tdjastrzebski/All-Purpose-Micro-Controller-2/Hardware/Order 2026-08.txt

667-EVQ-P0E07K	2
640-1006A0127C4084T	2
640-USB4105-GF-A-120	5
621-AP7361EA-33E-13	2
710-9774040243R	4
612-TL1014BF160QG	2
179-TS276824G260D	2
187-CL10C101JB8NNNC	4
581-KAM21BG82A101JT	8
179-TS27-CAP	2
637-BAT46WS	4
576-SZSMF6L5.0AT3G	2
241-SS2030FLAUR100A1	2
179-RIC122S11K5SUSMT	2
855-R25-1000602	8
710-9774030243R	8
649-20211120014T1LF	2
737-EBWA-05-A	6
737-2PH1R-03-UA	6
517-929870-01-08-30	2
713-110990037	2
81-1248AS-H-330MP3	2
6521-SRR5828A-3R3Y	2
512-FDT86102LZ	2
621-DMP6023LE-13	8
754-RR0816Q-110D	2
603-RT0603BRD07887KL	2
754-RR0816P-364D	2
754-RR0816P-271D	4
603-RT0603BRD071K69L	4
754-RR0816P-432D	6
603-RT0603DRE075K6L	2
754-RR0816P-681D	2
603-RT0603DRE073K3L	4
603-RT0603FRE07510RL	4
754-RR0816P-273D	2
667-EXB-2HV103JV	2
667-ERA-3AEB1623V	4
667-ERA-3AEB1153V	4
754-RR0816P-1912D28C	2
81-BLM18AG331SN1D	2
576-LCFE201202A900TG	2
595-TXU0202DCUR	4
511-M95P32-IXMNT/E	2
511-STM32U575CIT6	2
595-XTR200DQCR	4
595-TPS7A2031PDBVR	2
595-PCA9306TDCURQ1	2
595-LM74703QDDFRQ1	2
595-TPS62162DSGR	2
595-OPA2387DSGR	2
595-TPS259461ARPWR	2
595-TUSB320LAIRWBR	2
595-LMR38015SDRRR	2
511-STMPS2171STR	10
595-OPA387DBVR	2
575-8212200210002101	4
595-REF3425TIDBVR	2
511-STM32G071GBU6	2
595-ADS114S08BIRHBT	2
667-ERA-3AEB112V	10
603-RT0603BRD0768KL	10
81-GCM21BR71A225KA7K	10
754-RR0816P-271D	10
81-GCM21BR71A225KA7K	10
640-TBD05-02-1-G-G	2
640-TBD05-05-1-G-G	4
511-STM32U575CIT6	2
511-ST67W611M1A6UTR	2
538-146175-0001	2
575-8212200210002101	4
640-SIM8055611400A	2
595-TPD3F303DPVR	2
511-STM32U575CIT6	2
81-GRM0335C1E390FA1D	10
81-LQW15AN68NG00D	2
81-BLM18SD220SN1D	2
594-MCS04020C1004FE0	10
754-RG1005P-104DT10	10
200-RSP-122811-01	4
81-GRM022R60G104ME5L	20
