tdjastrzebski/All-Purpose-Micro-Controller-2/Hardware/APMC.kicad_pcb

## KiCad design Hardware/APMC.kicad_pcb (2026-09-16)

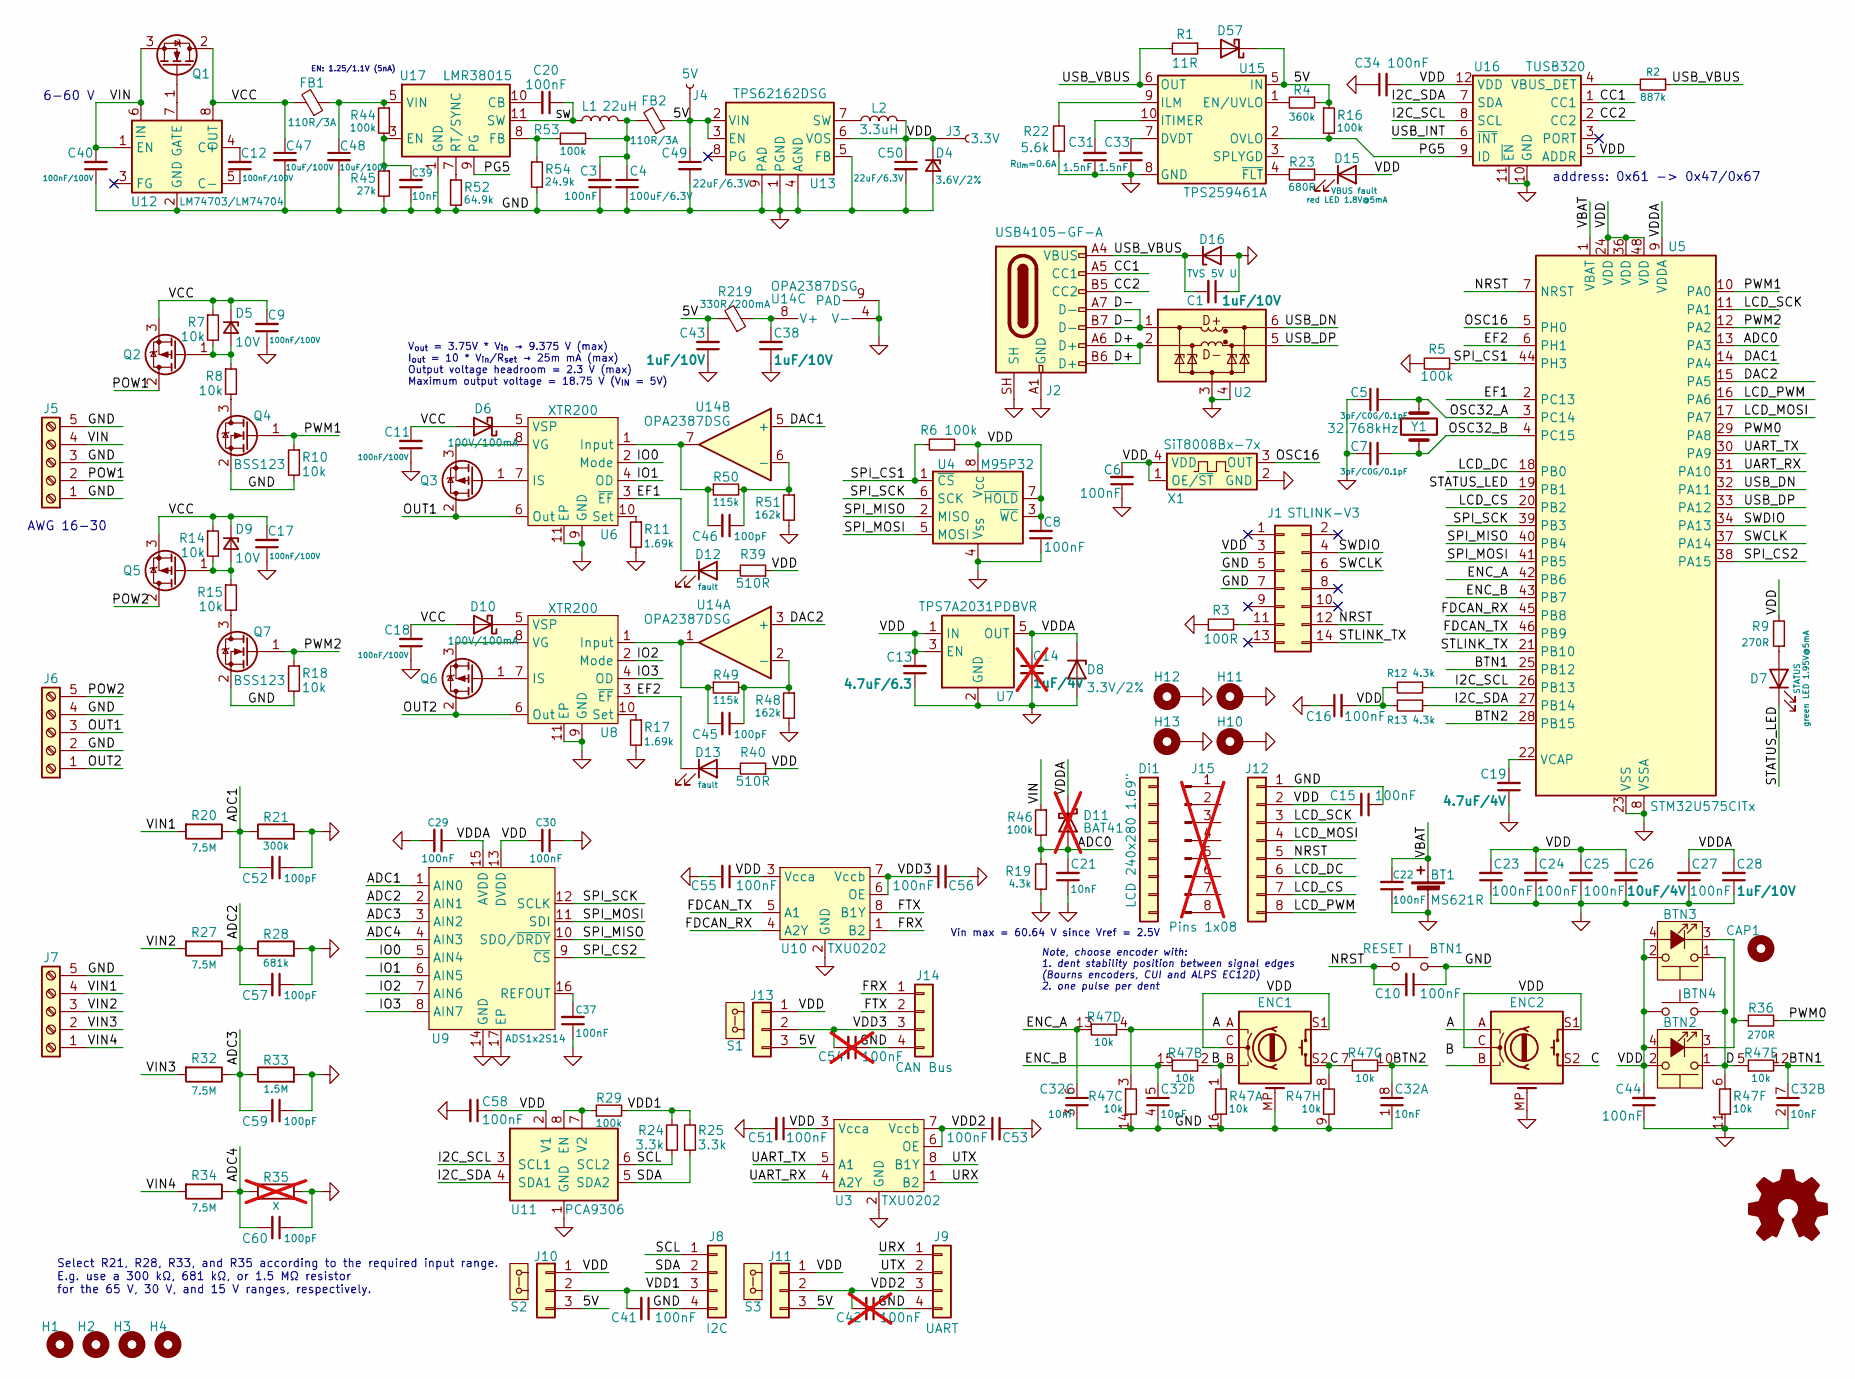
[picture p20: schematic APMC.kicad_sch, All-purpose Micro Controller (APMC)]

Parts:
BT1: MS621R; Seiko_MS621R-II27E; Mouser 628-MS621R-II27E
BTN1: tactile switch 4.7x3.5; SideTactileSwitch_4.7x3.5; Mouser 612-TL1014BF160QG
BTN2: tactile switch 6x6; tactile_switch_12x12_LED; Mouser 179-TS2912121G300D
BTN3: tactile switch 6x6; tactile_switch_6x6_LED; Mouser 179-TS276824G260D
BTN4: SW_Push; Schurter_MCS-18a; Mouser 693-1241.1104.7097
C1, C28, C38, C43: 1uF/10V; C_0603_1608Metric_Pad0.98x0.95mm_HandSolder; Mouser 810-CGA3E2X5R1A105MA
C3, C10, C15, C20, C23, C24, C27, C44: 100nF; C_0603_1608Metric_Pad1.08x0.95mm_HandSolder; Mouser 810-CGA3E2X7R1H104KE
C4: 100uF/6.3V; C_1812_4532Metric_Pad1.57x3.40mm_HandSolder; Mouser 810-C4532X5R0J107M
C5, C7: 3pF/C0G/0.1pF; C_0603_1608Metric_Pad0.98x0.95mm_HandSolder; Mouser 791-HH18N3R0B500CT
C6, C8, C16, C22, C25, C29, C30, C34, C37, C41, C51, C53, C55, C56, C58: 100nF; C_0603_1608Metric_Pad0.98x0.95mm_HandSolder; Mouser 810-CGA3E2X7R1H104KE
C9, C11, C12, C17, C18, C40: 100nF/100V; C_0805_2012Metric_Pad1.15x1.40mm_HandSolder; Mouser 810-CGA4J2X7R2A104MA
C13: 4.7uF/6.3; C_0603_1608Metric_Pad0.98x0.95mm_HandSolder; Mouser 187-CL10B475KQ8NQNC
C14: 1uF/4V; C_0603_1608Metric_Pad1.08x0.95mm_HandSolder; Mouser 810-CGA3E2X5R1A105KA; not fitted
C19: 4.7uF/4V; C_0603_1608Metric_Pad0.98x0.95mm_HandSolder; Mouser 187-CL10B475KQ8NQNC
C21, C39: 10nF; C_0603_1608Metric_Pad0.98x0.95mm_HandSolder; Mouser 81-GRM1857U1A103JA4D
C26: 10uF/4V; C_0805_2012Metric_Pad1.15x1.40mm_HandSolder; Mouser 810-CGA4J1X7R0J106K
C31, C33: 1.5nF; C_0603_1608Metric_Pad0.98x0.95mm_HandSolder; Mouser 81-GRM185C1H152JA01J
C32: 10nF; RC_Array_Isolated_4_0805; Mouser 603-CA508KRX7R7BB103
C42, C54: 100nF; C_0603_1608Metric_Pad1.08x0.95mm_HandSolder; Mouser 810-CGA3E2X7R1H104KE; not fitted
C45, C46: 100pF; C_0603_1608Metric_Pad0.98x0.95mm_HandSolder; Mouser 187-CL10C101JB8NNNC
C47, C48: 10uF/100V; C_1210_3225Metric_Pad1.33x2.70mm_HandSolder; Mouser 810-C3225X7R2A106K25
C49, C50: 22uF/6.3V; C_1206_3216Metric_Pad1.33x1.80mm_HandSolder; Mouser 187-CL31A226MOCLNNC
C52, C57, C59, C60: 100pF; 0603_0805; Mouser 581-KAM21BG82A101JT
CAP1: button cap; Mouser 179-TS27-CAP
D4: 3.6V/2%; D_SOD-323_HandSoldering; Mouser 771-PZU3.6B2A,115
D5, D9: 10V; D_SOD-323_HandSoldering; Mouser 771-PDZ10BF
D6, D10: 100V/100mA; D_SOD-323_HandSoldering; Mouser 637-BAT46WS
D7: Green LED; LED_0603_1608Metric_Pad1.05x0.95mm_HandSolder; Mouser 859-LTST-C190KGKT
D8: 3.3V/2%; D_SOD-323_HandSoldering; Mouser 863-MM3Z3V3ST1G
D11: BAT41; D_SOD-523; Mouser 511-BAT41KFILM; not fitted
D12, D13: Yellow LED; LED_0603_1608Metric_Pad1.05x0.95mm_HandSolder; Mouser 859-LTST-C190KSKT
D15: Red LED; LED_0603_1608Metric_Pad1.05x0.95mm_HandSolder; Mouser 859-LTST-C191KRKT
D16: TVS 5V U; D_SOD-123FL2; Mouser 576-SMF4L5.0A
D57: SS10200HE; D_SOD-123F; Mouser 241-SS2030FLAUR100A1
Di1: LCD 240x280 1.69"; Display_240x280_1.69_Generic
ENC1: PEC16-4220F-S0024; RotaryEncoder_Alps_EC12E-Switch_Vertical_H20mm; Mouser 652-PEC11R-4215K-S24
ENC2: Rotary_Encoder_Switch; CUI_RIC11-31SxxKx-GSMT; Mouser 179-RIC122S11K5SUSMT
FB1, FB2: 110R/3A; Fuse_1206_3216Metric_Pad1.42x1.75mm_HandSolder; Mouser 875-HI1206N101R-10
H1, H2, H3, H4: M2.5x6; MountingHole_2.5mm_Pad_Via; Mouser 855-R25-1000602
H10, H11, H12, H13: Standoff_M2x3.0; Wurth_Standoff_M2.0_A; Mouser 710-9774030243R
J1: Pin header Male 2x7 P:1.27; PinHeader_2x07_P1.27mm_Horizontal-UP-0.15; Mouser 649-20211120014T1LF
J2: USB4105-GF-A; Standard_USB-C_16; Mouser 640-USB4105-GF-A-120
J3, J4: PinHeader_1x01_P1.27mm_Vertical
J5, J6, J7: Terminal 1x5 P:3.5mm; Terminal_1x05_P3.5mm_Vertical; Mouser 737-EBWA-05-A
J8, J9, J14: Conn_01x04; SeedStudio_110990037, P2.0; Mouser 713-110990037
J10, J11, J13: Conn_01x03; PinHeader_1x03_P2.00mm_Vertical; Mouser 737-2PH1R-03-UA
J12: Conn_01x08; PinHeader_1x08_P2.54mm_Vertical; Mouser 517-929870-01-08-30
J15: Pins 1x08; Mouser 200-BBL108TF; not fitted
L1: 22uH; Inductor_Ferrite_8-10; Mouser 81-1274AS-H-220MP3
L2: 3.3uH; Inductor_5-6; Mouser 6521-SRR5828A-3R3Y
M1: Logo_Open_Hardware_Small; KiCad-Logo2_5mm_SilkScreen
Q1: FDT86102LZ; SOT-223-3_TabPin2; Mouser 512-FDT86102LZ
Q2, Q3, Q5, Q6: DMP6023LE; SOT-223-3_TabPin2; Mouser 621-DMP6023LE-13
Q4, Q7: BSS123; SOT-323_SC-70; Mouser 757-SSM3K7002CFULF
R1: 11R; R_0603_1608Metric_Pad0.98x0.95mm_HandSolder; Mouser 754-RR0816Q-110D
R2: 887k; R_0603_1608Metric_Pad0.98x0.95mm_HandSolder; Mouser 603-RT0603BRD07887KL
R3: 100R; R_0603_1608Metric_Pad0.98x0.95mm_HandSolder; Mouser 603-RT0603FRD07100RL
R4: 360k; R_0603_1608Metric_Pad0.98x0.95mm_HandSolder; Mouser 754-RR0816P-364D
R5, R6, R16, R29, R44, R46, R53: 100k; R_0603_1608Metric_Pad0.98x0.95mm_HandSolder; Mouser 754-RG1608P-104-B-T5
R7, R8, R10, R14, R15, R18: 10k; R_0603_1608Metric_Pad0.98x0.95mm_HandSolder; Mouser 603-RT0603DRD0710KL
R9, R36: 270R; R_0603_1608Metric_Pad0.98x0.95mm_HandSolder; Mouser 754-RR0816P-271D
R11, R17: 1.69k; R_0603_1608Metric_Pad0.98x0.95mm_HandSolder; Mouser 603-RT0603BRD071K69L
R12, R13, R19: 4.3k; R_0603_1608Metric_Pad0.98x0.95mm_HandSolder; Mouser 754-RR0816P-432D
R20, R27, R32, R34: 7.5M; 0603_0805; Mouser 594-MCU0805MD7504BP5
R21: 300k; 0603_0805; Mouser 754-RG2012P-304-BT5
R22: 5.6k; R_0603_1608Metric_Pad0.98x0.95mm_HandSolder; Mouser 603-RT0603DRE075K6L
R23: 680R; R_0603_1608Metric_Pad0.98x0.95mm_HandSolder; Mouser 754-RR0816P-681D
R24, R25: 3.3k; R_0603_1608Metric_Pad0.98x0.95mm_HandSolder; Mouser 603-RT0603DRE073K3L
R28: 681k; 0603_0805; Mouser 667-ERA-6AEB6813V
R33: 1.5M; 0603_0805; Mouser 754-RG2012P-155B-T5
R35: X; 0603_0805; not fitted
R39, R40: 510R; R_0603_1608Metric_Pad0.98x0.95mm_HandSolder; Mouser 603-RT0603FRE07510RL
R45: 27k; R_0603_1608Metric_Pad0.98x0.95mm_HandSolder; Mouser 754-RR0816P-273D
R47: 10k; RC_Array_Isolated_8_1506; Mouser 667-EXB-2HV103JV
R48, R51: 162k; R_0603_1608Metric_Pad0.98x0.95mm_HandSolder; Mouser 667-ERA-3AEB1623V
R49, R50: 115k; R_0603_1608Metric_Pad0.98x0.95mm_HandSolder; Mouser 667-ERA-3AEB1153V
R52: 64.9k; R_0603_1608Metric_Pad0.98x0.95mm_HandSolder; Mouser 754-RR0816P-1912D28C
R54: 24.9k; R_0603_1608Metric_Pad0.98x0.95mm_HandSolder; Mouser 754-RR0816P-2492D39C
R219: 330R/200mA; R_0603_1608Metric_Pad0.98x0.95mm_HandSolder; Mouser 81-BLM18AG331SN1D
S1, S2, S3: Shunt P: 2.0 mm; Mouser 737-MS2B-G
U2: LCFE201202A; Mouser 576-LCFE201202A900TG
U3, U10: TXU0202; VSSOP-8_2.3x2mm_P0.5mm; Mouser 595-TXU0202DCUR
U4: M95P32; SO-8_3.9x4.9mm_P1.27mm; Mouser 511-M95P32-IXMNT/E
U5: STM32U575CITx; LQFP-48_7x7mm_P0.5mm; Mouser 511-STM32U575CIT6
U6, U8: XTR200; WSON-10-1EP_2x3mm_P0.5mm_EP0.84x2.4mm_ThermalVias; Mouser 595-XTR200DQCR
U7: TPS7A2031PDBVR; SOT-23-5; Mouser 595-TPS7A2031PDBVR
U9: ADS1x2S14; WQFN-16-1EP_3x3mm_P0.5mm_EP1.68x1.68mm_ThermalVias; Mouser 595-ADS112S14IRTER
U11: PCA9306; VSSOP-8_2.3x2mm_P0.5mm; Mouser 595-PCA9306TDCURQ1
U12: LM74703/LM74704; SOT-23-8; Mouser 595-LM74703QDDFRQ1
U13: TPS62162DSG; WSON-8-1EP_2x2mm_P0.5mm_EP0.9x1.6mm_ThermalVias; Mouser 595-TPS62162DSGR
U14: OPA2387DSG; WSON-8-1EP_2x2mm_P0.5mm_EP0.9x1.6mm; Mouser 595-OPA2387DSGR
U15: TPS259461A; VQFN-HR-10-RPW; Mouser 595-TPS259461ARPWR
U16: TUSB320; Texas_X2QFN-12_1.6x1.6mm_P0.4mm; Mouser 595-TUSB320LAIRWBR
U17: LMR38015; TI_WSON-12-1EP_3x3mm_P0.5mm_EP1.3x2.5mm_ThermalVias; Mouser 595-LMR38015SDRRR
X1: SiT8008Bx-7x; Crystal_SMD_2016-4Pin_2.0x1.6mm; Mouser 788-8008BI7133S160G
Y1: 32.768kHz; Crystal_SMD_MicroCrystal_CC7V-T1A-2Pin_3.2x1.5mm; Mouser 520-.327-CDX-1128

Connections:
/5V: C43.2, C49.1, D57.1 (K), FB2.1, J4.1 (Pin_1_1), J10.3, J11.3, J13.3, R4.1, R16.1, R219.2, U13.2 (VIN), U13.3 (EN), U15.5 (IN)
/A: ENC1.A, ENC2.A, R47.3 (e), R47.4 (R4.1)
/ADC0: C21.2, D11.2 (A), R19.1, R46.2, U5.13 (PA3)
/ADC1: C52.2, R20.1, R21.1, U9.1 (AIN0)
/ADC2: C57.2, R27.1, R28.1, U9.2 (AIN1)
/ADC3: C59.2, R32.1, R33.1, U9.3 (AIN2)
/ADC4: C60.2, R34.1, R35.1, U9.4 (AIN3)
/B: ENC1.B, R47.1 (R1.1), R47.2 (R2.1)
/BTN1: C32.7 (C2.2), R47.12 (R5.2), U5.25 (PB12)
/BTN2: C32.8 (C1.2), R47.10 (R7.2), U5.28 (PB15)
/C: ENC1.S2, ENC2.S2, R47.7 (R7.1), R47.8 (R8.1)
/CC1: J2.A5 (CC1), U16.1 (CC1)
/CC2: J2.B5 (CC2), U16.2 (CC2)
/D: BTN2.1, BTN3.1, BTN4.2, R47.5 (R5.1), R47.6 (R6.1)
/D+: J2.A6 (D+), J2.B6 (D+), U2.2 (D-_in)
/D-: J2.A7 (D-), J2.B7 (D-), U2.1 (D+_in)
/DAC1: U5.14 (PA4), U14.5 (+)
/DAC2: U5.15 (PA5), U14.3 (+)
/EF1: D12.1 (K), U5.2 (PC13), U6.3 (~EF)
/EF2: D13.1 (K), U5.6 (PH1), U8.3 (~EF)
/ENC_A: C32.6 (C3.2), R47.13 (R4.2), U5.42 (PB6)
/ENC_B: C32.5 (C4.2), R47.15 (R2.2), U5.43 (PB7)
/FDCAN_RX: U5.45 (PB8), U10.4 (A2Y)
/FDCAN_TX: U5.46 (PB9), U10.5 (A1)
/FRX: J14.1, U10.1 (B2)
/FTX: J14.2, U10.8 (B1Y)
/I2C_SCL: R12.1, U5.26 (PB13), U11.3 (SCL1), U16.8 (SCL)
/I2C_SDA: R13.1, U5.27 (PB14), U11.4 (SDA1), U16.7 (SDA)
/IO0: U6.2 (Mode), U9.5 (AIN4)
/IO1: U6.4 (OD), U9.6 (AIN5)
/IO2: U8.2 (Mode), U9.7 (AIN6)
/IO3: U8.4 (OD), U9.8 (AIN7)
/LCD_CS: J12.7, U5.20 (PB2)
/LCD_DC: J12.6, U5.18 (PB0)
/LCD_MOSI: J12.4, U5.17 (PA7)
/LCD_PWM: J12.8, U5.16 (PA6)
/LCD_SCK: J12.3, U5.11 (PA1)
/NRST: BTN1.1, C10.2, J1.12, J12.5, U5.7 (NRST)
/OSC16: U5.5 (PH0), X1.3 (OUT)
/OSC32_A: C5.2, U5.3 (PC14), Y1.1
/OSC32_B: C7.2, U5.4 (PC15), Y1.2
/OUT1: J6.3, Q3.2 (D), U6.6 (Out)
/OUT2: J6.1, Q6.2 (D), U8.6 (Out)
/PG5: R16.2, U15.2 (OVLO), U16.9 (ID), U17.9 (PG)
/POW1: J5.2, Q2.2 (D)
/POW2: J6.5, Q5.2 (D)
/PWM0: R36.2, U5.29 (PA8)
/PWM1: Q4.1 (G), R10.1, U5.10 (PA0)
/PWM2: Q7.1 (G), R18.1, U5.12 (PA2)
/SCL: J8.1, R24.1, U11.6 (SCL2)
/SDA: J8.2, R25.1, U11.5 (SDA2)
/SPI_CS1: R5.1, R6.2, U4.1 (~CS), U5.44 (PH3)
/SPI_CS2: U5.38 (PA15), U9.9 (~CS)
/SPI_MISO: U4.2 (MISO), U5.40 (PB4), U9.10 (SDO/~DRDY)
/SPI_MOSI: U4.5 (MOSI), U5.41 (PB5), U9.11 (SDI)
/SPI_SCK: U4.6 (SCK), U5.39 (PB3), U9.12 (SCLK)
/STATUS_LED: D7.1 (K), U5.19 (PB1)
/STLINK_TX: J1.14, U5.21 (PB10)
/SW: C20.1, L1.1, U17.11 (SW), U17.12 (SW)
/SWCLK: J1.6, U5.37 (PA14)
/SWDIO: J1.4, U5.34 (PA13)
/UART_RX: U3.4 (A2Y), U5.31 (PA10)
/UART_TX: U3.5 (A1), U5.30 (PA9)
/URX: J9.1, U3.1 (B2)
/USB_DN: U2.6 (D+_out), U5.32 (PA11)
/USB_DP: U2.5 (D-_out), U5.33 (PA12)
/USB_INT: U16.6 (~INT)
/USB_VBUS: C1.2, D16.1 (K), J2.A4 (VBUS), J2.A9 (VBUS), J2.B4 (VBUS), J2.B9 (VBUS), R1.2, R2.1, U15.6 (OUT)
/UTX: J9.2, U3.8 (B1Y)
/VBAT: BT1.1 (+), C22.2, U5.1 (VBAT)
/VCC: C9.2, C11.2, C17.2, C18.2, C47.1, D5.1 (K), D6.2 (A), D9.1 (K), D10.2 (A), FB1.2, Q1.2 (D), Q2.3 (S), Q5.3 (S), R7.1, R14.1, U12.8 (OUT)
/VDD: BTN2.2, BTN2.4 (A), BTN3.2, BTN3.4 (A), BTN4.1, C6.2, C8.2, C13.2, C15.2, C16.2, C23.2, C24.2, C25.2, C26.2, C30.2, C34.2, C44.2, C50.1, C51.1, C55.1, C58.1, D4.1 (K), D15.2 (A), ENC1.C, ENC1.S1, ENC2.C, ENC2.S1, J1.3, J3.1 (Pin_1_1), J10.1, J11.1, J12.2, J13.1, L2.2, R6.1, R9.2, R12.2, R13.2, R39.1, R40.1, U3.3 (Vcca), U4.3 (~WC), U4.7 (~HOLD), U4.8 (V_{CC}), U5.24 (VDD), U5.36 (VDD), U5.48 (VDD), U7.1 (IN), U7.3 (EN), U9.13 (DVDD), U10.3 (Vcca), U11.2 (V1), U13.6 (VOS), U16.5 (ADDR), U16.12 (VDD), X1.1 (OE/~ST), X1.4 (VDD)
/VDD1: C41.2, J8.3, J10.2, R24.2, R25.2, R29.2
/VDD2: C42.2, C53.1, J9.3, J11.2, U3.6 (OE), U3.7 (Vccb)
/VDD3: C54.2, C56.1, J13.2, J14.3, U10.6 (OE), U10.7 (Vccb)
/VDDA: C14.1, C27.2, C28.2, C29.1, D8.1 (K), D11.1 (K), U5.9 (VDDA), U7.5 (OUT), U9.15 (AVDD)
/VIN: C40.2, J5.4, Q1.3 (S), R46.1, U12.1 (EN), U12.6 (IN)
/VIN1: J7.4, R20.2
/VIN2: J7.3, R27.2
/VIN3: J7.2, R32.2
/VIN4: J7.1, R34.2
GND: BT1.2 (-), BTN1.2, C1.1, C3.1, C4.2, C5.1, C6.1, C7.1, C8.1, C9.1, C10.1, C11.1, C13.1, C14.2, C15.1, C16.1, C17.1, C18.1, C19.1, C21.1, C22.1, C23.1, C24.1, C25.1, C26.1, C27.1, C28.1, C29.2, C30.1, C31.1, C32.1 (C1.1), C32.2 (C2.1), C32.3 (C3.1), C32.4 (C4.1), C33.1, C34.1, C37.1, C38.1, C39.1, C40.1, C41.1, C42.1, C43.1, C44.1, C47.2, C48.2, C49.2, C50.2, C51.2, C52.1, C53.2, C54.1, C55.2, C56.2, C57.1, C58.2, C59.1, C60.1, D4.2 (A), D8.2 (A), D16.2 (A), ENC1.MP, ENC2.MP, H10.1 (1_1), H11.1 (1_1), H12.1 (1_1), H13.1 (1_1), J1.5, J1.7, J2.A1 (GND), J2.A12 (GND), J2.B1 (GND), J2.B12 (GND), J2.SH, J5.1, J5.3, J5.5, J6.2, J6.4, J7.5, J8.4, J9.4, J12.1, J14.4, Q4.2 (S), Q7.2 (S), R3.1, R5.2, R10.2, R11.2, R17.2, R18.2, R19.2, R21.2, R22.1, R28.2, R33.2, R35.2, R45.2, R47.9 (R8.2), R47.11 (R6.2), R47.14 (R3.2), R47.16 (R1.2), R48.2, R51.2, R52.2, R54.2, U2.3 (GND), U2.4 (NC), U3.2 (GND), U4.4 (V_{SS}), U5.8 (VSSA), U5.23 (VSS), U5.35 (VSS), U5.47 (VSS), U6.9 (GND), U6.11 (EP), U7.2 (GND), U8.9 (GND), U8.11 (EP), U9.14 (GND), U9.17 (EP), U10.2 (GND), U11.1 (GND), U12.2 (GND), U13.1 (PGND), U13.4 (AGND), U13.5 (FB), U13.9 (PAD), U14.4 (V-), U14.9 (PAD), U15.8 (GND), U16.10 (GND), U16.11 (~EN), U17.1 (GND), U17.2 (GND), U17.13 (GND), X1.2 (GND)
unnamed: BTN2.3 (K), BTN3.3 (K), R36.1
unnamed: C3.2, C4.1, FB2.2, L1.2, R53.2
unnamed: C48.1, FB1.1, R44.1, U17.5 (VIN), U17.6 (VIN)
unnamed: D5.2 (A), Q2.1 (G), R7.2, R8.1
unnamed: D6.1 (K), U6.5 (VSP)
unnamed: D7.2 (A), R9.1
unnamed: D9.2 (A), Q5.1 (G), R14.2, R15.1
unnamed: D10.1 (K), U8.5 (VSP)
unnamed: D12.2 (A), R39.2
unnamed: D13.2 (A), R40.2
unnamed: D15.1 (K), R23.2
unnamed: D57.2 (A), R1.1
unnamed: J1.11, R3.2
unnamed: Q1.1 (G), U12.7 (GATE)
unnamed: Q3.1 (G), U6.7 (IS)
unnamed: Q3.3 (S), U6.8 (VG)
unnamed: Q4.3 (D), R8.2
unnamed: Q6.1 (G), U8.7 (IS)
unnamed: Q6.3 (S), U8.8 (VG)
unnamed: Q7.3 (D), R15.2
unnamed: C19.2, U5.22 (VCAP)
unnamed: C46.2, R50.1, U6.1 (Input), U14.7
unnamed: R11.1, U6.10 (Set)
unnamed: C45.2, R49.1, U8.1 (Input), U14.1
unnamed: R17.1, U8.10 (Set)
unnamed: C37.2, U9.16 (REFOUT)
unnamed: R29.1, U11.7 (V2), U11.8 (EN)
unnamed: C12.2, U12.4 (C+)
unnamed: C12.1, U12.5 (C-)
unnamed: L2.1, U13.7 (SW)
unnamed: C45.1, R48.1, R49.2, U14.2 (-)
unnamed: C46.1, R50.2, R51.1, U14.6 (-)
unnamed: C38.2, R219.1, U14.8 (V+)
unnamed: C33.2, U15.7 (DVDT)
unnamed: R4.2, U15.1 (EN/UVLO)
unnamed: R22.2, U15.9 (ILM)
unnamed: C31.2, U15.10 (ITIMER)
unnamed: R23.1, U15.4 (~FLT)
unnamed: R2.2, U16.4 (VBUS_DET)
unnamed: C20.2, U17.10 (CB)
unnamed: C39.2, R44.2, R45.1, U17.3 (EN)
unnamed: R53.1, R54.1, U17.8 (FB)
unnamed: R52.1, U17.7 (RT/SYNC)

Notes on the sheet:
Note, choose encoder with: 1. dent stability position between signal edges (Bourns encoders, CUI and ALPS EC12D) 2. one pulse per dent
EN: 1.25/1.1V (5nA)
Vin max = 60.64 V since Vref = 2.5V
address: 0x61 -> 0x47/0x67
V_{out} = 3.75V * V_{in} → 9.375 V (max) I_{out} = 10 * V_{in}/R_{set} → 25m mA (max) Output voltage headroom = 2.3 V (max) Maximum output voltage = 18.75 V (V_{IN} = 5V)
6-60 V
AWG 16-30
Select R21, R28, R33, and R35 according to the required input range. E.g. use a 300 kΩ, 681 kΩ, or 1.5 MΩ resistor for the 65 V, 30 V, and 15 V ranges, respectively.

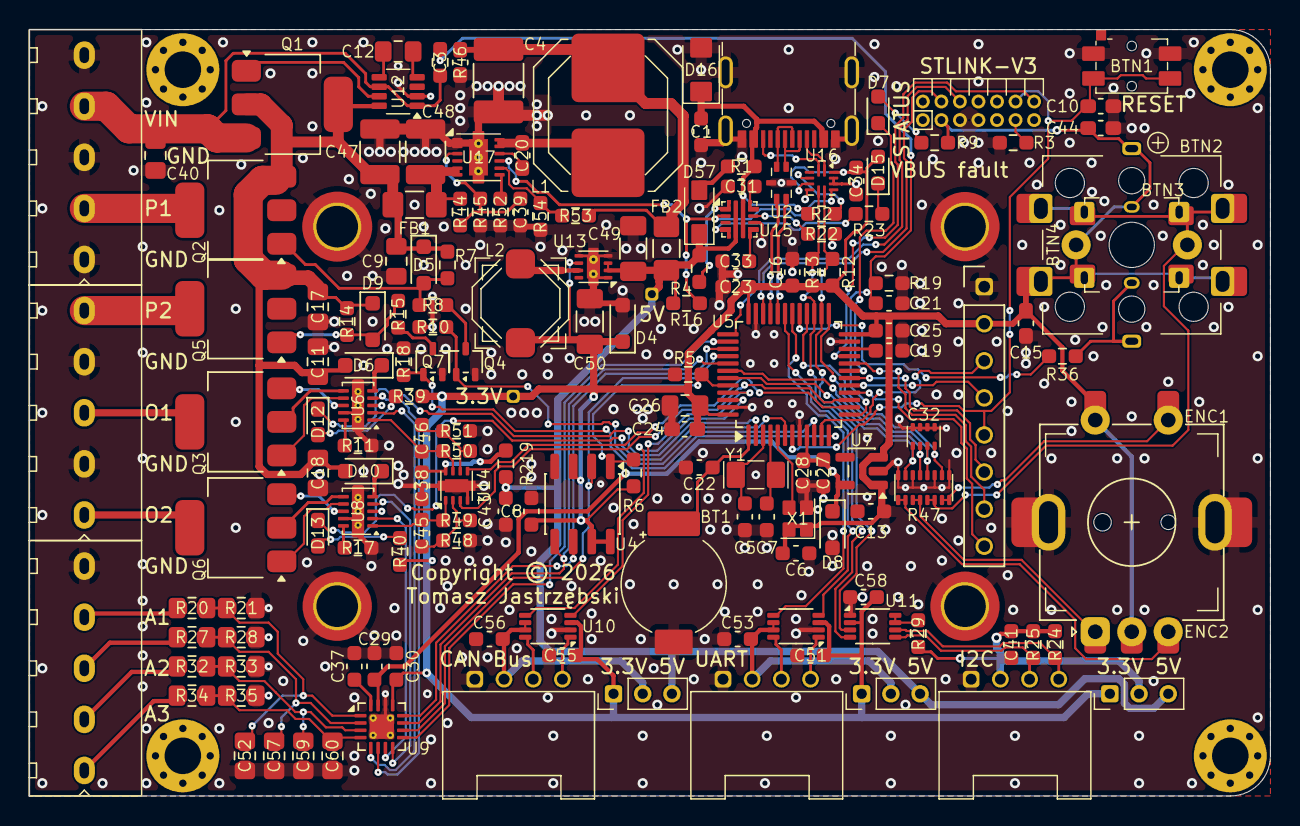
[picture p21: board APMC.kicad_pcb from above]

Board: 2 copper layers, 85.0 x 52.5 mm, 172 parts (1 on the bottom side), 124 nets.
