tdjastrzebski/All-Purpose-Micro-Controller-2/Firmware/Core/Src/main.c

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
/* Includes ------------------------------------------------------------------*/
#include "main.h"

/* USER CODE BEGIN Includes */
#include "stdio.h"
#include "terminal_colors.h"
#include "master.h"
/* USER CODE END Includes */

ADC_HandleTypeDef hadc1;

DAC_HandleTypeDef hdac1;

DCACHE_HandleTypeDef hdcache1;

DMA2D_HandleTypeDef hdma2d;

FDCAN_HandleTypeDef hfdcan1;

I2C_HandleTypeDef hi2c2;

RTC_HandleTypeDef hrtc;

SPI_HandleTypeDef hspi1;
SPI_HandleTypeDef hspi3;
DMA_HandleTypeDef handle_GPDMA1_Channel0;

TIM_HandleTypeDef htim1;
TIM_HandleTypeDef htim2;
TIM_HandleTypeDef htim4;
TIM_HandleTypeDef htim5;
TIM_HandleTypeDef htim6;
TIM_HandleTypeDef htim7;
TIM_HandleTypeDef htim16;

UART_HandleTypeDef huart1;
UART_HandleTypeDef huart3;

HCD_HandleTypeDef hhcd_USB_OTG_FS;

void SystemClock_Config(void);
static void MX_GPIO_Init(void);
static void MX_GPDMA1_Init(void);
static void MX_FDCAN1_Init(void);
static void MX_USART1_UART_Init(void);
static void MX_USB_OTG_FS_HCD_Init(void);
static void MX_TIM5_Init(void);
static void MX_SPI3_Init(void);
static void MX_ICACHE_Init(void);
static void MX_RTC_Init(void);
static void MX_DAC1_Init(void);
static void MX_ADC1_Init(void);
static void MX_I2C2_Init(void);
static void MX_SPI1_Init(void);
static void MX_TIM2_Init(void);
static void MX_TIM4_Init(void);
static void MX_TIM16_Init(void);
static void MX_USART3_UART_Init(void);
static void MX_DCACHE1_Init(void);
static void MX_DMA2D_Init(void);
static void MX_TIM1_Init(void);
static void MX_TIM6_Init(void);
static void MX_TIM7_Init(void);
/* USER CODE BEGIN 0 */
#ifdef __GNUC__
#define PUTCHAR_PROTOTYPE int __io_putchar(int ch)
#else
#define PUTCHAR_PROTOTYPE int fputc(int ch, FILE *f)
#endif

PUTCHAR_PROTOTYPE {
	HAL_StatusTypeDef status = HAL_UART_Transmit(&huart3, (uint8_t *)&ch, 1, HAL_MAX_DELAY);
  if (status != HAL_OK) {
    printf("\n");
  }
	return ch;
}
/* USER CODE END 0 */

/**
  * @brief  The application entry point.
  * @retval int
  */
int main(void)
{

  /* USER CODE BEGIN 1 */
  PreInit();
  /* USER CODE END 1 */

  /* MCU Configuration--------------------------------------------------------*/

  /* Reset of all peripherals, Initializes the Flash interface and the Systick. */
  HAL_Init();

  /* USER CODE BEGIN Init */
  Init();
  /* USER CODE END Init */

  /* Configure the system clock */
  SystemClock_Config();

  /* USER CODE BEGIN SysInit */
  SysInit();
  /* USER CODE END SysInit */

  /* Initialize all configured peripherals */
  MX_GPIO_Init();
  MX_GPDMA1_Init();
  MX_FDCAN1_Init();
  MX_USART1_UART_Init();
  MX_USB_OTG_FS_HCD_Init();
  MX_TIM5_Init();
  MX_SPI3_Init();
  MX_ICACHE_Init();
  MX_RTC_Init();
  MX_DAC1_Init();
  MX_ADC1_Init();
  MX_I2C2_Init();
  MX_SPI1_Init();
  MX_TIM2_Init();
  MX_TIM4_Init();
  MX_TIM16_Init();
  MX_USART3_UART_Init();
  MX_DCACHE1_Init();
  MX_DMA2D_Init();
  MX_TIM1_Init();
  MX_TIM6_Init();
  MX_TIM7_Init();
  /* USER CODE BEGIN 2 */
  PostInit();
  /* USER CODE END 2 */

  /* Infinite loop */
  /* USER CODE BEGIN WHILE */
  while (1)
  {
    MainLoop();
    /* USER CODE END WHILE */

    /* USER CODE BEGIN 3 */
  }
  /* USER CODE END 3 */
}

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
