tdjastrzebski/All-Purpose-Micro-Controller-2/Firmware/master.cpp

#include "master.h"

#include <stdarg.h>
#include <stdio.h>
#include <time.h>

#include "Sub_RTC.h"
#include "Timer.h"
#include "ads1x2s14_drv.h"
#include "dwt_timer.h"
#include "lvgl_sub.h"
#include "m95p32_drv.h"
#include "my_printf.h"
#include "spi_drv.h"
#include "st7789_drv.h"
#include "stm32u5xx_ll_utils.h"
#include "terminal_colors.h"

extern TIM_HandleTypeDef EncoderTimer;
extern TIM_HandleTypeDef LcdPwmTimer;
extern SPI_HandleTypeDef LcdSpi;
extern SPI_HandleTypeDef BoardSpi;
extern RTC_HandleTypeDef RtcTimer;
extern TIM_HandleTypeDef htim1;

static timer_ctx _lcdPwmTimer = {.tim = &LcdPwmTimer, .channel = timer_ch1};
static timer_ctx _ledPwmTimer = {.tim = &htim1, .channel = timer_ch1};
static spi_channel_dev_ctx _lcd_spi = {.channel = &LcdSpi, .cs_port = LCD_CS_GPIO_Port, .cs_pin = LCD_CS_Pin};
static spi_channel_dev_ctx _eeprom_spi = {.channel = &BoardSpi, .cs_port = SPI_CS1_GPIO_Port, .cs_pin = SPI_CS1_Pin};
static spi_channel_dev_ctx _adc_spi = {.channel = &BoardSpi, .cs_port = SPI_CS2_GPIO_Port, .cs_pin = SPI_CS2_Pin};

static void _encoderTimerCaptureCallback(TIM_HandleTypeDef* htim);
static void _rtcAlarmAEventCallback(RTC_HandleTypeDef* hrtc);

void PreInit(void) {}

void SysInit(void) {}

void Init(void) {
	HAL_PWREx_EnableBatteryCharging(PWR_BATTERY_CHARGING_RESISTOR_1_5);
	HAL_PWREx_DisableUCPDDeadBattery();
}

void PostInit(void) {
	// rtc_SetDate(26, 07, 26, 6);
	// rtc_SetTime(14, 06, 30);

	HAL_Delay(100);  // wait a bit more
	time_t dateTime = rtc_GetDateTime();
	tm* dt = gmtime(&dateTime);
	my_printf("\n" YELLOW("* restarted %.2i:%.2i:%.2i *") "\n", dt->tm_hour, dt->tm_min, dt->tm_sec);

	dwt_init();  // always init

	HAL_StatusTypeDef result;

	if (HAL_TIM_Encoder_Start_IT(&EncoderTimer, TIM_CHANNEL_1 | TIM_CHANNEL_2) != HAL_OK) {
		Error_Handler();
	}

	timer_init(40000000.0);
	timer_start_pwm(&_lcdPwmTimer, 100.0, 0.5);
	timer_start_pwm(&_ledPwmTimer, 100.0, 0.1);

	st7789_Init(&_lcd_spi);

	st7789_FillScreen(&_lcd_spi, st7789_color_black);

	bool eepromReady = m95p32_Init(&_eeprom_spi);
	if (eepromReady) {
		my_printf(GREEN("ext eeprom memory test passed") "\n");
	} else {
		my_printf(RED("ext eeprom memory test failed") "\n");
	}

	// Draw a single green pixel at (120, 140)
	st7789_DrawPixel(&_lcd_spi, 120, 140, st7789_color_blue);

	for (uint16_t i = 0; i < 240; i++) {
		st7789_DrawPixel(&_lcd_spi, i, 140, st7789_color_blue);
		st7789_DrawPixel(&_lcd_spi, i, 10, st7789_color_blue);
		st7789_DrawPixel(&_lcd_spi, i, 269, st7789_color_blue);
	}
	for (uint16_t i = 0; i < 280; i++) {
		st7789_DrawPixel(&_lcd_spi, 10, i, st7789_color_green);
		st7789_DrawPixel(&_lcd_spi, 120, i, st7789_color_green);
		st7789_DrawPixel(&_lcd_spi, 230, i, st7789_color_green);
	}

	ads1x2s14_resolution resolution = ads1x2s14_init(&_adc_spi);
	if (resolution != ads1x2s14_resolution_unknown) {
		my_printf(GREEN("ads1x2s14_init OK") "\n");
	} else {
		my_printf(RED("ads1x2s14_init failed") "\n");
	}
	bool adcReady;
	adcReady = ads1x2s14_gpio_config(&_adc_spi, 0, ads1x2s14_gpio_pushPull);
	adcReady = ads1x2s14_gpio_config(&_adc_spi, 1, ads1x2s14_gpio_pushPull);
	adcReady = ads1x2s14_gpio_config(&_adc_spi, 2, ads1x2s14_gpio_pushPull);
	adcReady = ads1x2s14_gpio_config(&_adc_spi, 3, ads1x2s14_gpio_pushPull);
	adcReady = ads1x2s14_gpio_setState(&_adc_spi, 0, true);   // Mode1 = current
	adcReady = ads1x2s14_gpio_setState(&_adc_spi, 1, false);  // Disable1 = disabled
	adcReady = ads1x2s14_gpio_setState(&_adc_spi, 2, true);   // Mode2 = current
	adcReady = ads1x2s14_gpio_setState(&_adc_spi, 3, false);  // Disable2 = disabled
	adcReady = ads1x2s14_pga_setGain(&_adc_spi, ads1x2s14_gain_1);
	adcReady = ads1x2s14_ref_set(&_adc_spi, ads1x2s14_ref_int2_5V);
	adcReady = ads1x2s14_mux_select(&_adc_spi, ads1x2s14_mux_ain0);
	adcReady = ads1x2s14_digital_config(&_adc_spi, ads1x2s14_coding_unipolar, false);
	adcReady = ads1x2s14_dev_config(&_adc_spi, false, false, ads1x2s14_cnvMode_singleShot, ads1x2s14_speed_512kHz);
	adcReady = ads1x2s14_cnv_start(&_adc_spi);
	dwt_delay(1000000);
	uint32_t data = 0;
	ads1x2s14_status status;
	adcReady = ads1x2s14_data_read(&_adc_spi, &data);
	adcReady = ads1x2s14_status_read(&_adc_spi, &status);

	lvgl_init();

	EncoderTimer.IC_CaptureCallback = _encoderTimerCaptureCallback;
	RtcTimer.AlarmAEventCallback = _rtcAlarmAEventCallback;
}

void MainLoop(void) {
	static uint32_t pattern = 0xF0F0CCC0;
	static uint32_t shift = 0;
	static uint32_t count = 0;

	if (count == 0) {
		HAL_GPIO_WritePin(STATUS_LED_GPIO_Port, STATUS_LED_Pin, (pattern >> shift) & 0x1 ? GPIO_PIN_SET : GPIO_PIN_RESET);
		shift++;
		shift %= 32;
	}
	count++;
	count %= 20;

	const float MinBrightness = 0.05f;
	const float MaxBrightness = 0.80f;
	const float Period = 2.5f;  // seconds
	float t = HAL_GetTick() * 0.001f;
	float phase = 2.0f * 3.1415926f * t / Period;
	float x = (expf(sinf(phase)) - expf(-1.0f)) / (expf(1.0f) - expf(-1.0f));
	float dutyCycle = MinBrightness + (MaxBrightness - MinBrightness) * x;
	timer_start_pwm(&_ledPwmTimer, 100.0, dutyCycle);

	HAL_Delay(10);
}

static void _rtcAlarmAEventCallback(RTC_HandleTypeDef* hrtc) {
	time_t dateTime = rtc_GetDateTime();
	tm* dt = gmtime(&dateTime);
	lvgl_showTime(dt);
	static bool flag;
	uint32_t data = 0;
	ads1x2s14_status status;
	if (flag) {
		ads1x2s14_cnv_start(&_adc_spi);
	} else {
		ads1x2s14_data_read(&_adc_spi, &data);
		ads1x2s14_status_read(&_adc_spi, &status);
		float value = (data / 65535.0) * 65.0;
		my_printf("adc %i, cnt %i, %.2f\n", data, status.conv_count, value);
	}
	flag = !flag;
}

static void _encoderTimerCaptureCallback(TIM_HandleTypeDef* htim) {
	int16_t count = (int16_t)__HAL_TIM_GET_COUNTER(&EncoderTimer);
	if (__HAL_TIM_IS_TIM_COUNTING_DOWN(htim)) {
		my_printf(" down c %i\n", count);
	} else {
		my_printf(" up c %i\n", count);
	}
	lvgl_showNumber(count);
}

void HAL_GPIO_EXTI_Rising_Callback(uint16_t GPIO_Pin) {
	time_t dateTime = rtc_GetDateTime();
	tm* dt = gmtime(&dateTime);
	my_printf("\n" YELLOW("* clicked at %.2i:%.2i:%.2i *") "\n", dt->tm_hour, dt->tm_min, dt->tm_sec);

	switch (GPIO_Pin) {
	case BTN1_Pin: {
		my_printf(" BTN1 INT\n");
		break;
	}
	case BTN2_Pin: {
		my_printf(" BTN2 INT\n");
		break;
	}
	}
}

void HAL_GPIO_EXTI_Falling_Callback(uint16_t GPIO_Pin) {
	switch (GPIO_Pin) {
	case EF1_Pin: {
		my_printf(" EF1 INT\n");
		break;
	}
	case EF2_Pin: {
		my_printf(" EF2 INT\n");
		break;
	}
	}
}
