tdjastrzebski/All-Purpose-Micro-Controller-2/Firmware/lvgl_sub.h

#ifdef __cplusplus
extern "C" {
#endif

#include <time.h>

#define SCREEN_WIDTH 280
#define SCREEN_HEIGHT 240

void lvgl_init(void);
void lvgl_showNumber(int8_t number);
void lvgl_showTime(tm* dt);
// void lvgl_tick(uint8_t period);
// void lvgl_task(uint8_t period);

#ifdef __cplusplus
}
#endif
