tdjastrzebski/All-Purpose-Micro-Controller-2/Firmware/master.h

#pragma once

#ifdef __cplusplus
extern "C" {
#endif

// to be included in the main.c "USER CODE 1" section
void PreInit(void);
// to be included in the main.c "USER CODE Init" section
void Init(void);
// to be included in the main.c "USER CODE SysInit" section
void SysInit(void);
// to be included in the main.c "USER CODE 2" section
void PostInit(void);

void MainLoop(void);

#ifdef __cplusplus
}
#endif
