tdjastrzebski/All-Purpose-Micro-Controller-2/(commit log)

2026-07-15 initial revision
    [APMC.kicad_pcb, APMC.kicad_sch]
2026-07-15 PCB image added
2026-07-15 note on input voltage added
2026-07-16 PCB image update
2026-07-18 BOM revised
    [APMC-BOM.csv, APMC.kicad_pcb, APMC.kicad_sch]
2026-07-19 schematic fix
    [APMC-BOM.csv, APMC.kicad_pcb, APMC.kicad_sch]
2026-07-19 R19 fix
    [APMC-BOM.csv, APMC.kicad_pcb, APMC.kicad_sch]
2026-07-19 label fix
    [APMC.kicad_pcb, APMC.kicad_sch]
2026-07-21 post-prod updates
    [APMC.kicad_pcb, APMC.kicad_sch]
2026-07-21 images updated
    [APMC-BOM.csv]
2026-07-21 BOM fix
    [APMC-BOM.csv, APMC.kicad_sch]
2026-07-22 post-prod fixes
    [APMC-BOM.csv, APMC.kicad_pcb, APMC.kicad_sch]
2026-07-25 initial firmware
    [APMC.kicad_pcb, APMC.kicad_sch, STM32U5x_STLink.cfg]
2026-07-25 initial firmware version working
    [APMC.kicad_pcb]
2026-07-26 current image added
2026-07-26 DBCC fix
    [APMC.kicad_pcb]
2026-07-26 LVGL timer fix
    [APMC.kicad_pcb]
2026-07-26 ENC timer fix
2026-07-26 button LED "breaths"
2026-07-26 rev 2.0 current state
2026-07-26 LCD pin header modified
    [APMC-BOM.csv, APMC.kicad_pcb, APMC.kicad_sch]
2026-07-28 PCB refined
    [APMC.kicad_pcb]
2026-08-16 rev 2.1 work in progress
    [APMC-BOM.csv, APMC.kicad_pcb, APMC.kicad_sch]
2026-08-22 Schematic update
    [APMC.kicad_sch]
2026-09-15 work on ADC communication
    [APMC.csv, APMC.kicad_pcb, APMC.kicad_sch]
2026-09-15 ads1x2s14 gpio mgmt
    [APMC.kicad_sch]
2026-09-16 ads1x2s14 VMP impl
    [APMC.kicad_pcb, APMC.kicad_sch]
2026-09-17 adc first time works
2026-09-18 ads1x2s14 reads correct values
    [ads1x2s14_drv.cpp, ads1x2s14_drv.h, lvgl_sub.cpp, m95p32_drv.cpp, m95p32_drv.h, master.cpp, st7789_drv.cpp, st7789_drv.h]
