tdjastrzebski/All-Purpose-Micro-Controller-2/(notices)

Notices in the files:
Firmware/Core/Inc/main.h:
Copyright (c) 2026 STMicroelectronics.
All rights reserved.
This software is licensed under terms that can be found in the LICENSE file
Hardware/APMC.kicad_pcb:
Copyright © 2026 Tomasz Jastrzębski
License: CC BY-NC-ND 4.0
Copyright © 2026 Tomasz Jastrzębski, License: CC BY-NC-ND 4.0
